adafruit/Adafruit-Feather-M0-WiFi-WINC1500-PCB/README.md

# Adafruit-Feather-M0-WiFi-WINC1500-PCB
PCB files for the Adafruit Feather M0 WiFi (with WINC1500) PCB

Format is EagleCAD schematic and board layout

For more details, check out the product page at

  * https://www.adafruit.com/product/3010

Adafruit invests time and resources providing this open source design, 
please support Adafruit and open-source hardware by purchasing 
products from Adafruit!

Designed by Adafruit Industries.  
Creative Commons Attribution, Share-Alike license, check license.txt for more information
All text above must be included in any redistribution
