adafruit/Adafruit-Feather-M0-WiFi-WINC1500-PCB/(commit log)

2019-05-15 Deleting brd file
    [Adafruit Feather M0 WiFi.brd]
2019-05-15 Deleting sch file
    [Adafruit Feather M0 WiFi.sch]
2019-05-15 Updating files.
    [Adafruit Feather M0 WiFi.brd, Adafruit Feather M0 WiFi.sch]
